AbhinavA10/Rescue-Heroes/Software/Rescue-Bot/src/examples/README.md

This folder houses a collection of misc. examples or older programs to test sensors.

The `main.cpp` file can be replaced with each `.ino` file here, or the `.ino` file can potentially be run using the `Arduino IDE`.
