AbhinavA10/Rescue-Heroes/Electrical/Block-Diagram/Block_Diagram.pdf

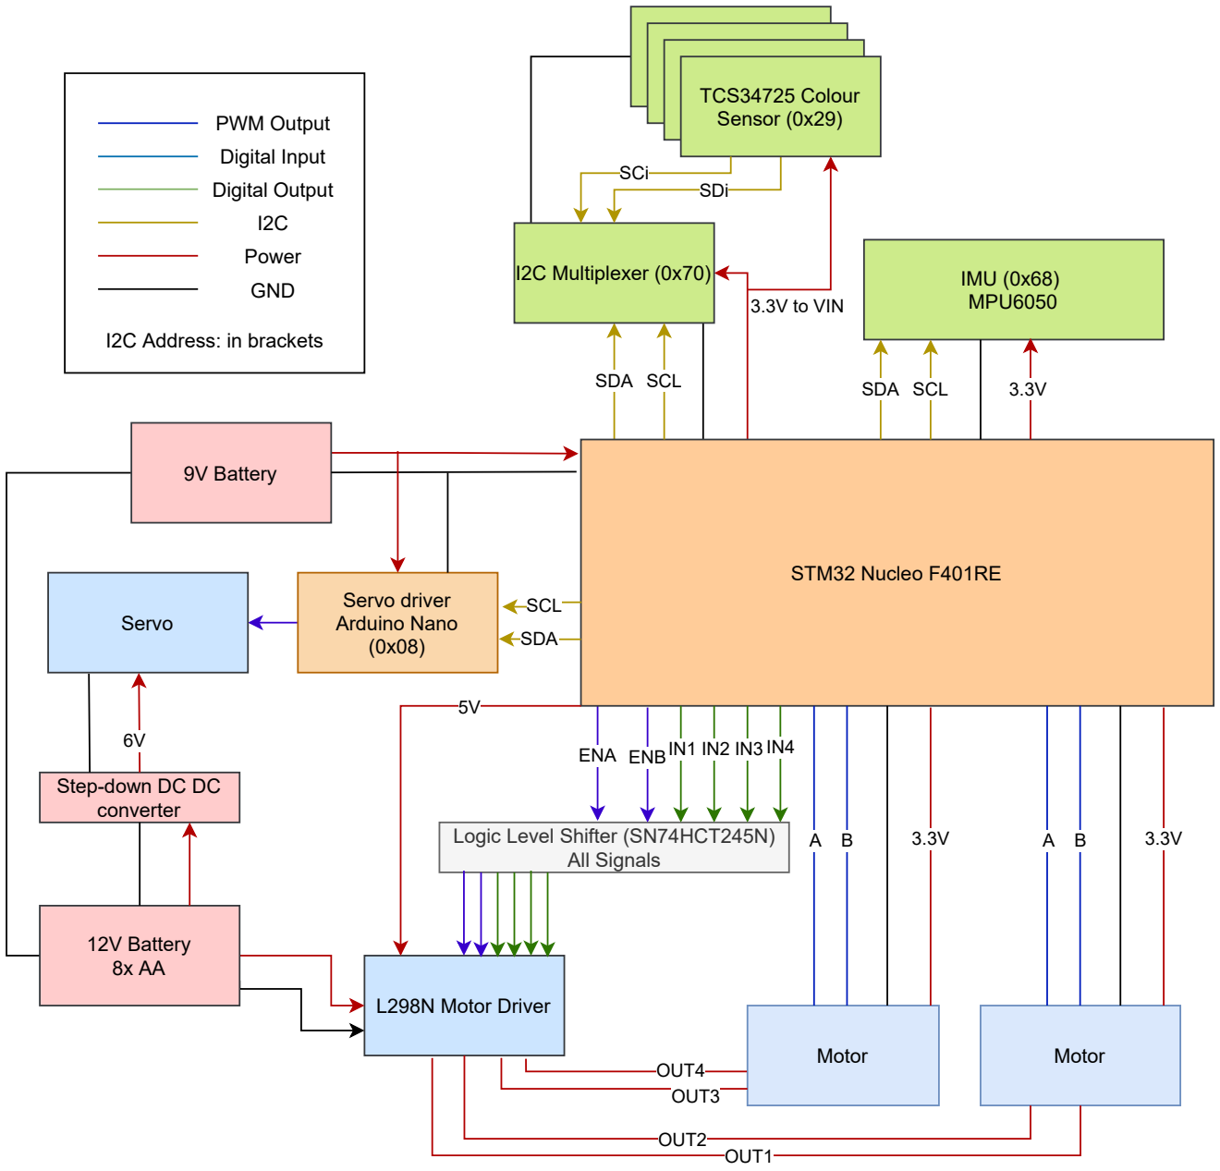
[picture p12: figure]
ENA; 3.3V to VIN; SDA; STM32 Nucleo F401RE; I2C Multiplexer (0x70); TCS34725 Colour Sensor TCS34725 Colour Sensor TCS34725 Colour Sensor; SDi; TCS34725 Colour Sensor (0x29); L298N Motor Driver; Motor; IMU (0x68) MPU6050; Servo; OUT3; OUT4; OUT1; OUT2; 12V Battery 8x AA; 9V Battery; SCi; SCL; SDA SCL; Logic Level Shifter (SN74HCT245N) All Signals; Step-down DC DC converter; ENBIN1 IN2 IN3; Digital Input; Digital Output; Power; GND; PWM Output; I2C Address: in brackets; Servo driver Arduino Nano

OLED Screen (I2C)
(Debugging)
(0x3C)

Buzzer
(Debugging)
