AbhinavA10/Rescue-Heroes/images/delay.png

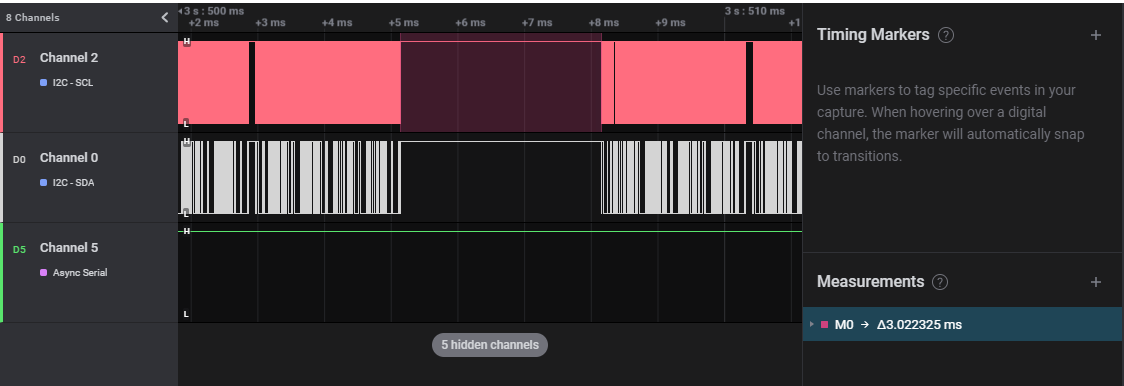
images/delay.png
