AbhinavA10/Rescue-Heroes/images/no_delay.png

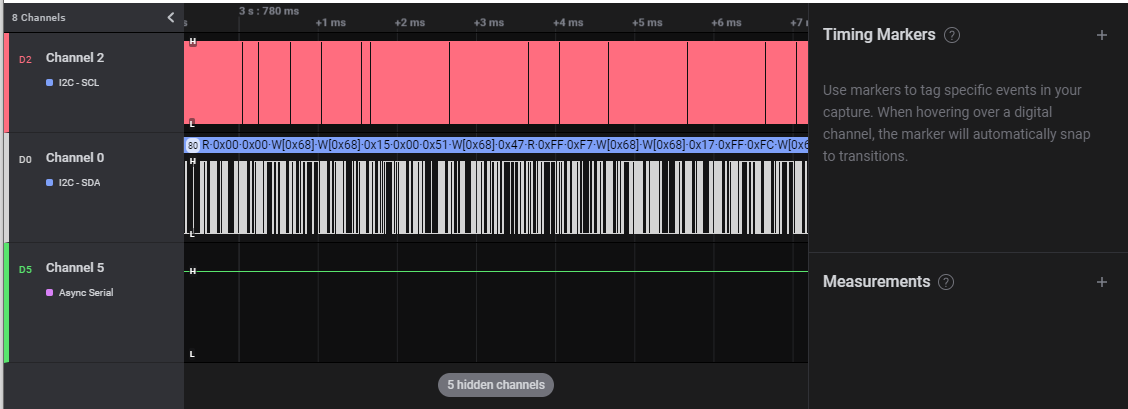
images/no_delay.png
