AbhinavA10/Rescue-Heroes/images/render1_exploded.jpg

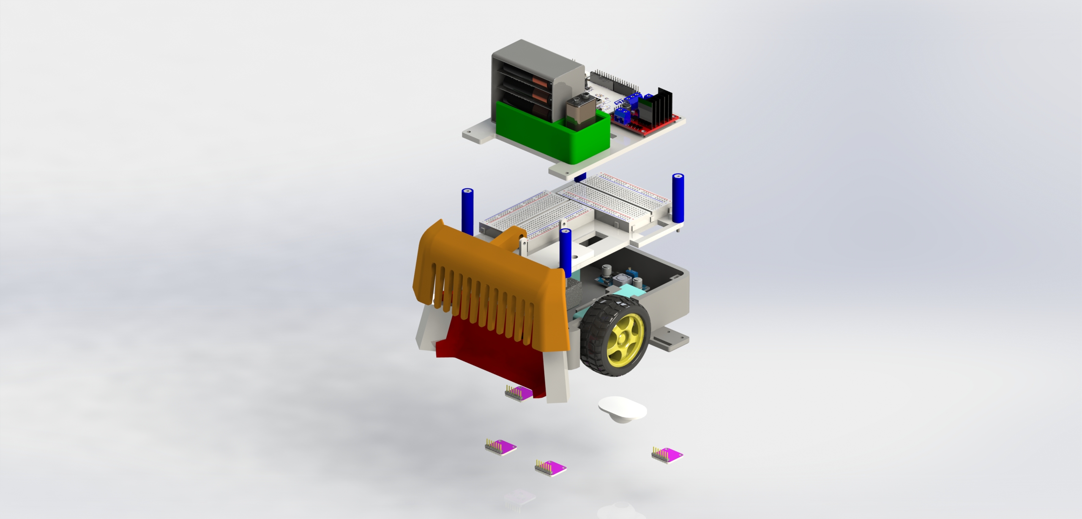
images/render1_exploded.jpg
