AbhinavA10/Rescue-Heroes/Software/Algorithm_Flowcharts/software_algo_dropping.png

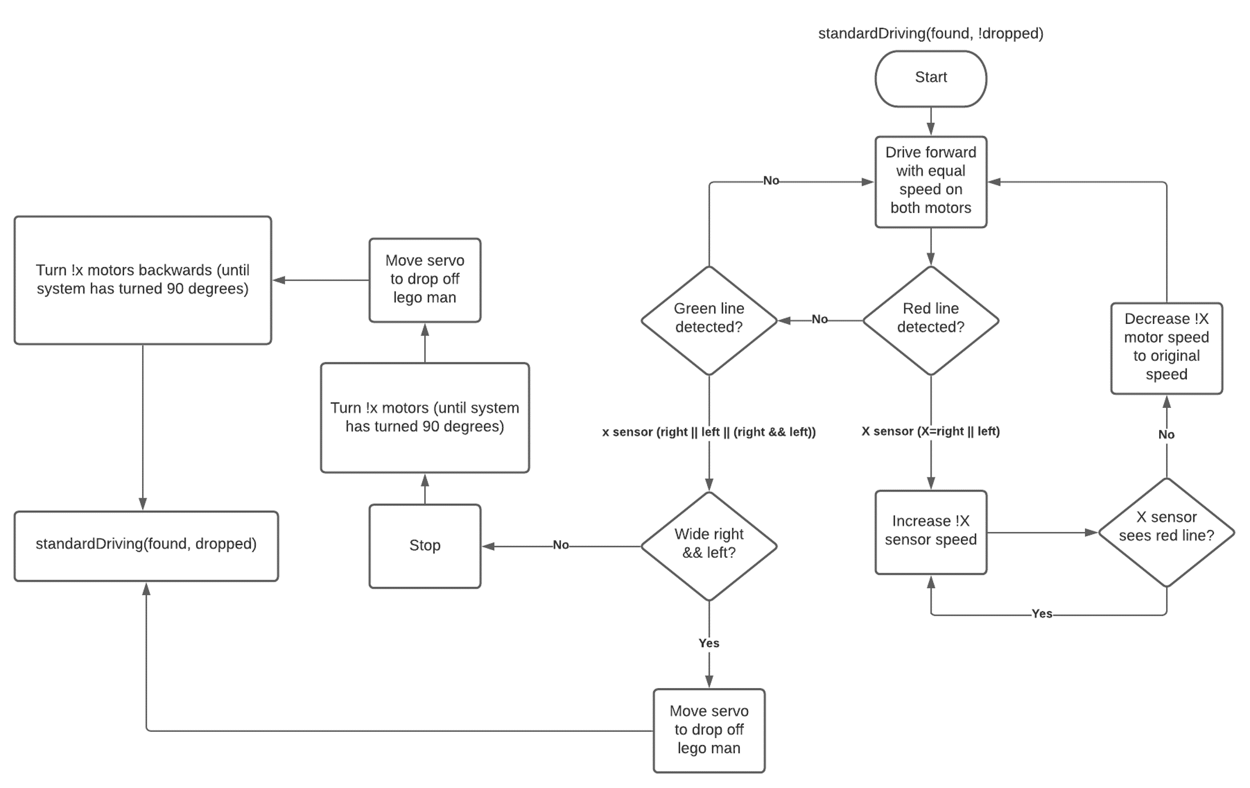
Software/Algorithm_Flowcharts/software_algo_dropping.png
