AbhinavA10/Rescue-Heroes/Software/Algorithm_Flowcharts/software_algo_finding.png

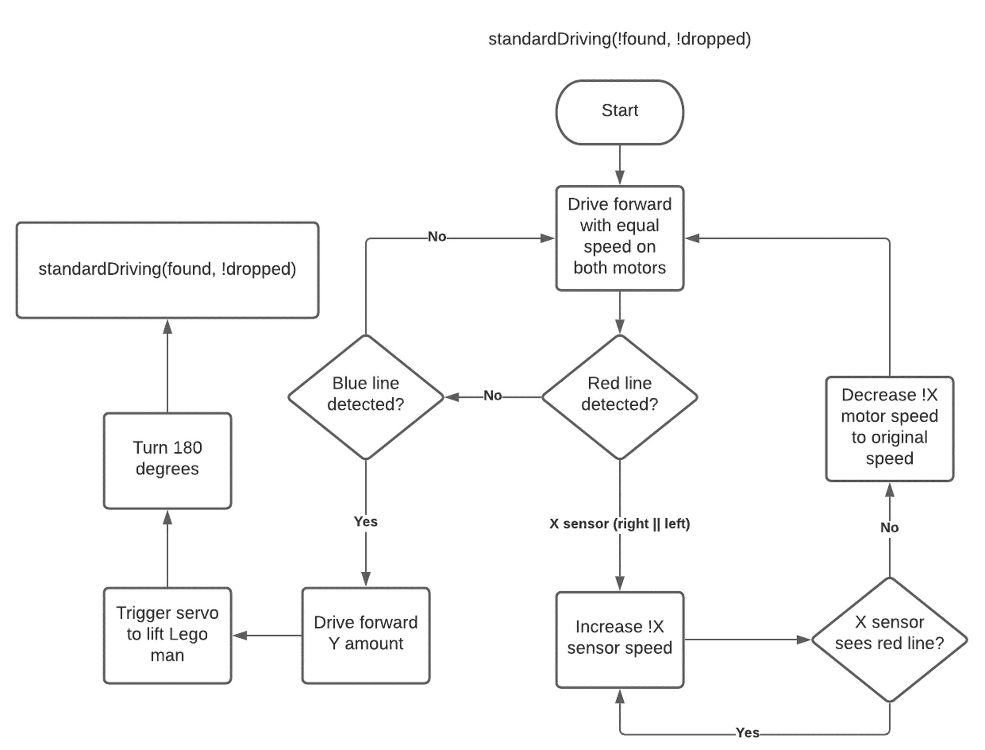
Software/Algorithm_Flowcharts/software_algo_finding.png
