AbhinavA10/Rescue-Heroes/Software/Algorithm_Flowcharts/software_algo_overview.png

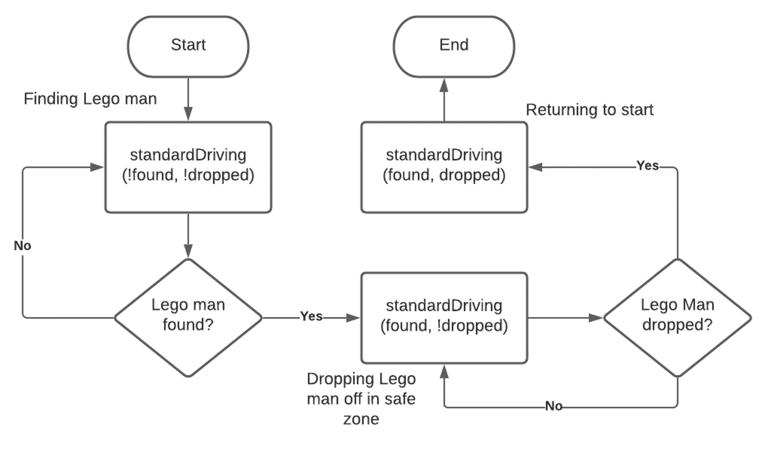
Software/Algorithm_Flowcharts/software_algo_overview.png
