AbhinavA10/Rescue-Heroes/Software/Algorithm_Flowcharts/software_algo_returning.png

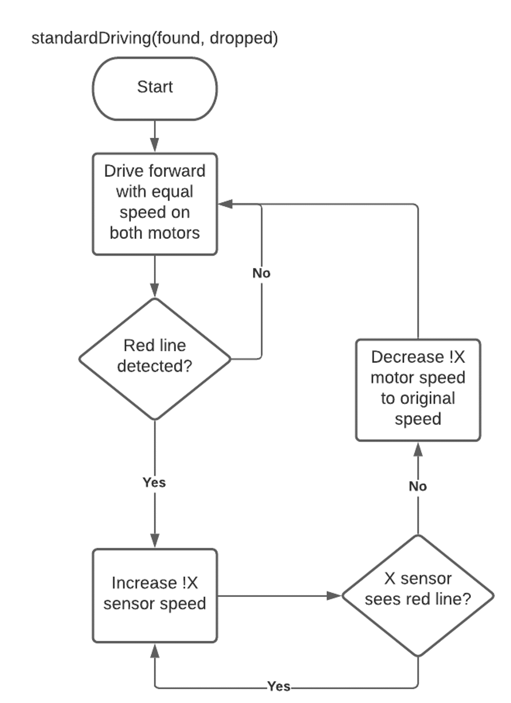
Software/Algorithm_Flowcharts/software_algo_returning.png
