AbhinavA10/Rescue-Heroes/Software/Computer_Colour_Visualization/adafruit_colour_plot.png

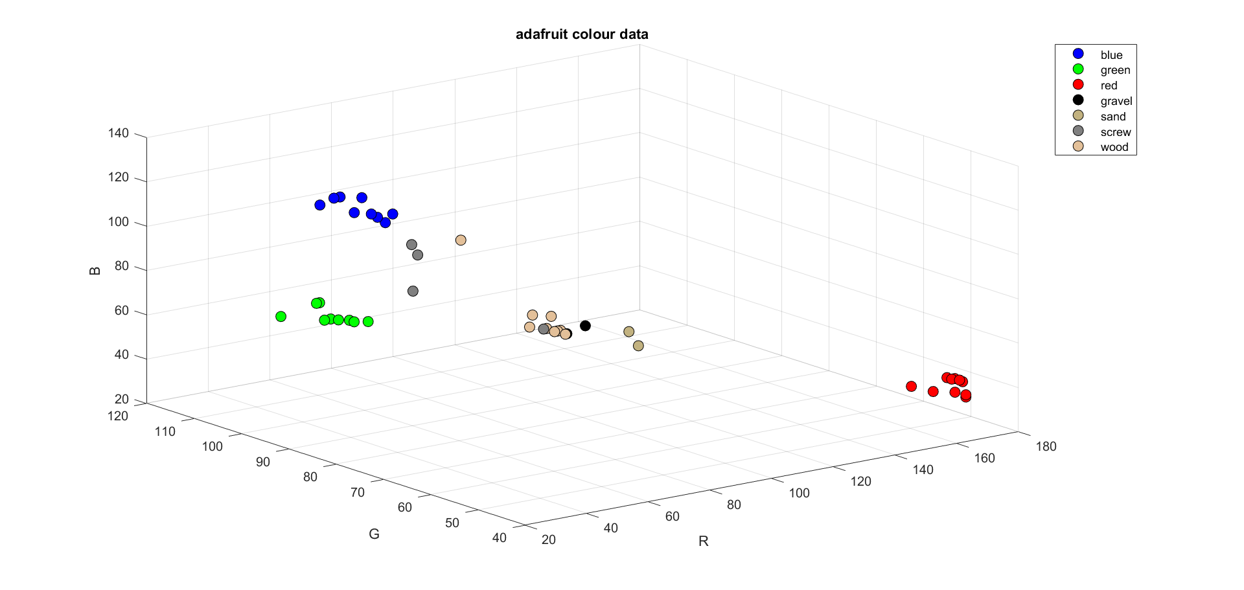
Software/Computer_Colour_Visualization/adafruit_colour_plot.png
