AbhinavA10/Rescue-Heroes/Software/Computer_Colour_Visualization/ebay_colour_plot.png

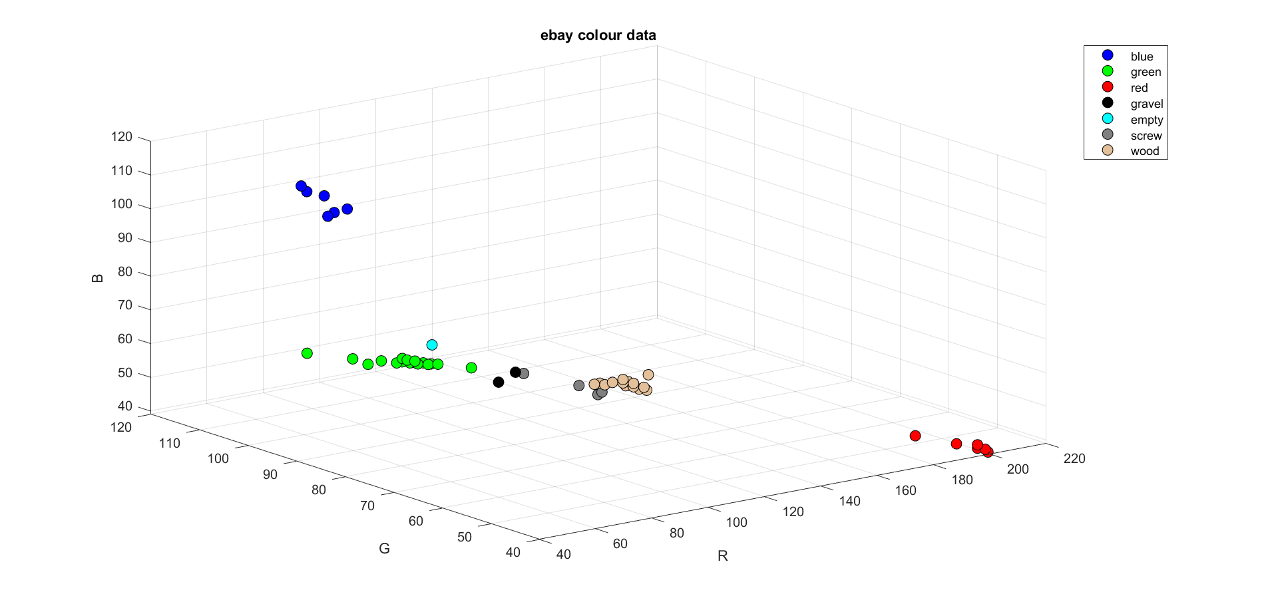
Software/Computer_Colour_Visualization/ebay_colour_plot.png
