AbhinavA10/Rescue-Heroes/Software/Computer_Colour_Visualization/Spheres/spheres_ebay.png

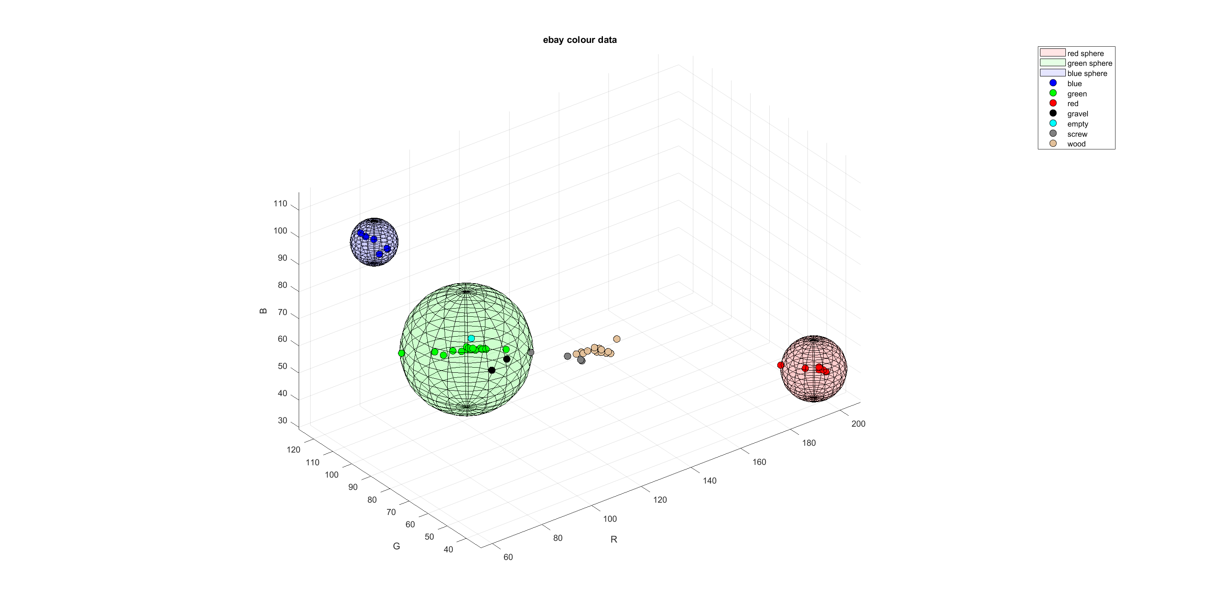
Software/Computer_Colour_Visualization/Spheres/spheres_ebay.png
