AbhinavA10/Rescue-Heroes/Software/Human_Colour_Visualization/ebay_colour_plot_human_visualization.png

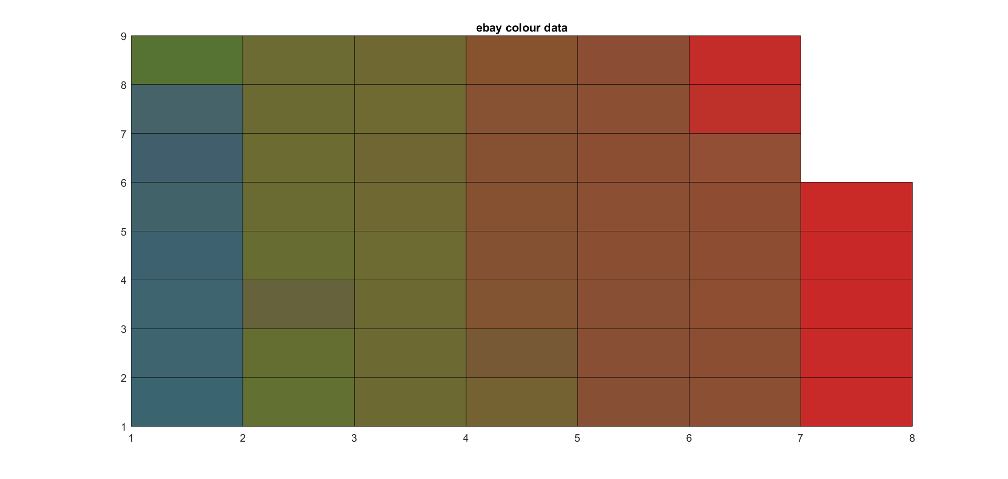
Software/Human_Colour_Visualization/ebay_colour_plot_human_visualization.png
