AbhinavA10/Rescue-Heroes/images/Robot_Assembly_Drawing.pdf

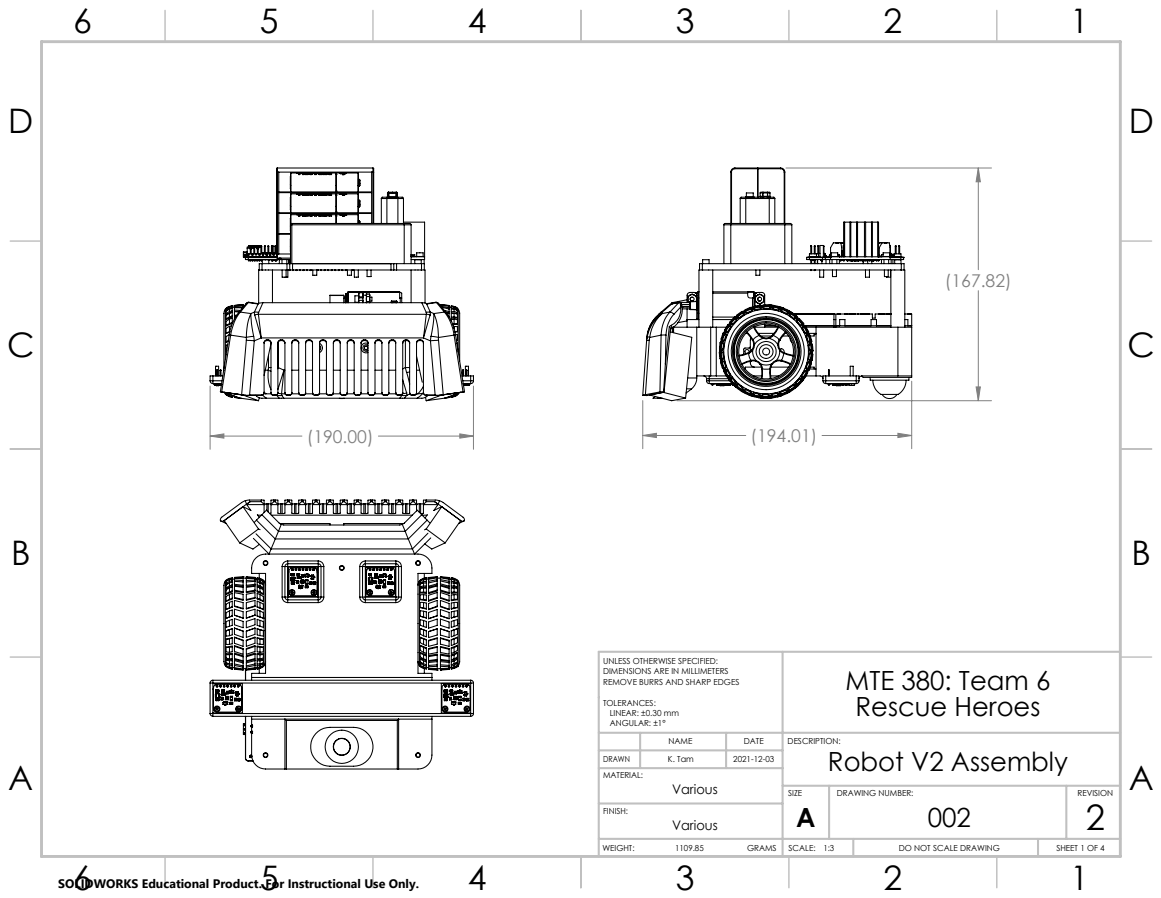
[picture p26: page 1]
DRAWING NUMBER:; SHEET 1 OF 4; GRAMS; DO NOT SCALE DRAWING

UNLESS OTHERWISE SPECIFIED: DIMENSIONS ARE IN MILLIMETERS REMOVE BURRS AND SHARP EDGES TOLERANCES: LINEAR: ±0.30 mm ANGULAR: ±1° | MTE 380: Team 6 Rescue Heroes

NAME | DATE | DESCRIPTION: Robot V2 Assembly SIZE

DRAWN | K. Tam | 2021-12-03

SOLIDWORKS Educational Product. For Instructional Use Only.

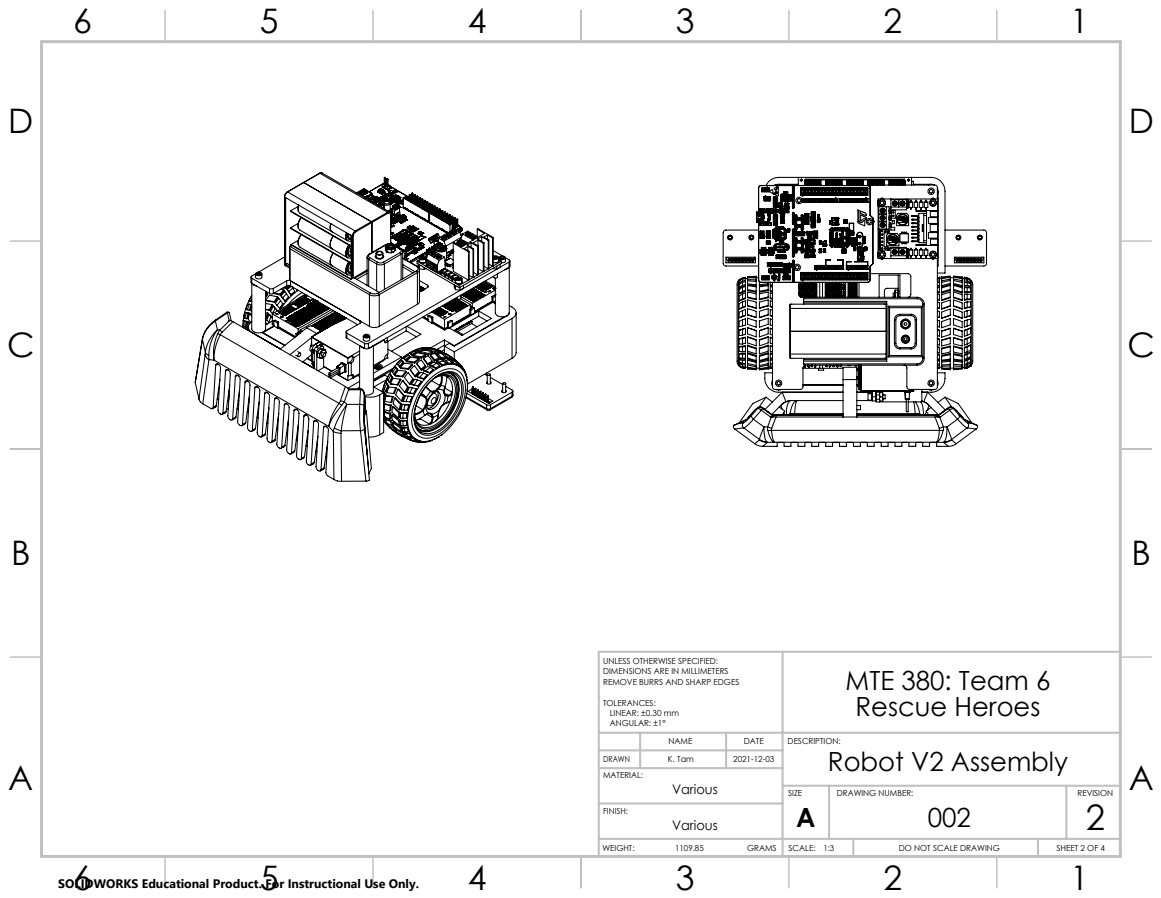
[picture p27: page 2]
DRAWING NUMBER:; GRAMS; DO NOT SCALE DRAWING

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

NAME | DATE | DESCRIPTION: Robot V2 Assembly SIZE

DRAWN | K. Tam | 2021-12-03

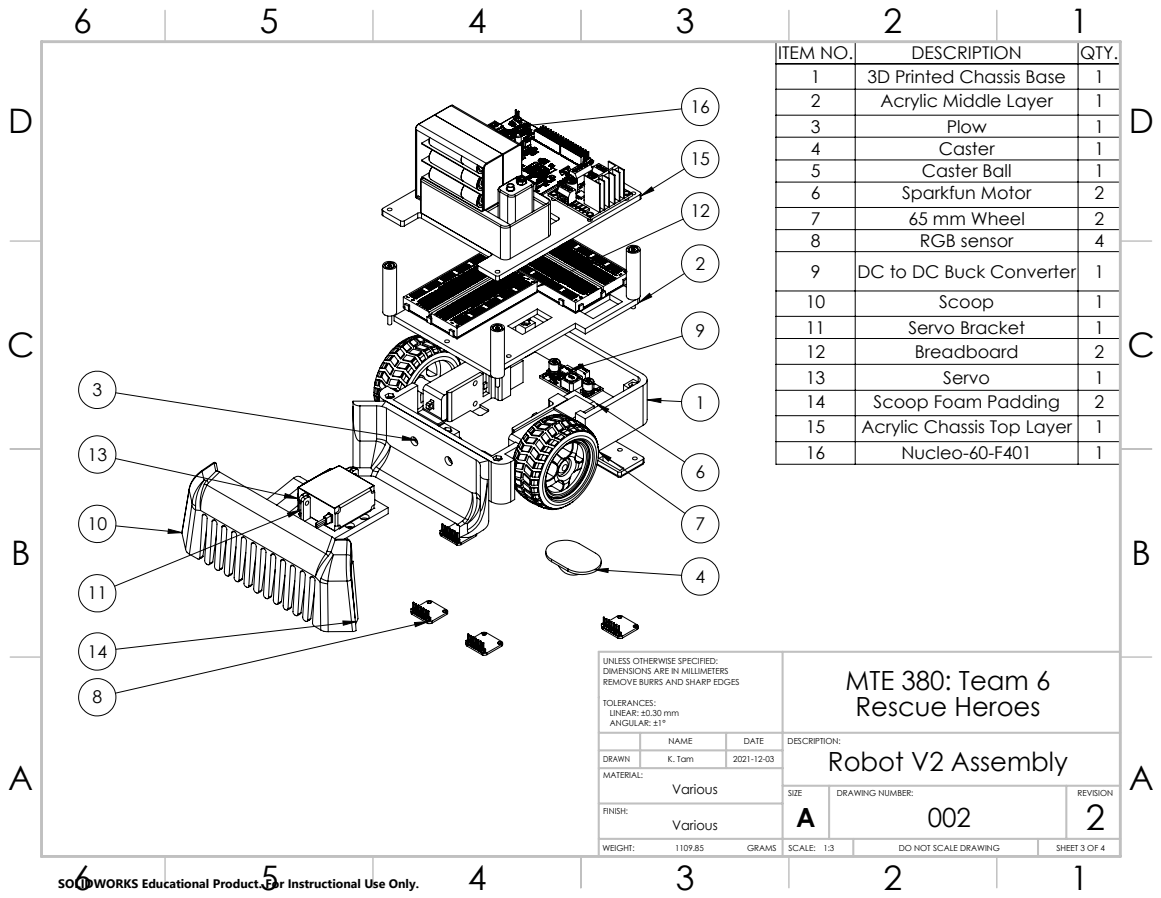
[picture p28: page 3]
DRAWING NUMBER:; GRAMS; DO NOT SCALE DRAWING

ITEM NO. | DESCRIPTION | QTY.
1 | 3D Printed Chassis Base | 1
2 | Acrylic Middle Layer | 1
3 | Plow | 1
4 | Caster | 1
5 | Caster Ball | 1
6 | Sparkfun Motor | 2
7 | 65 mm Wheel | 2
8 | RGB sensor | 4
9 | DC to DC Buck Converter | 1
10 | Scoop | 1
11 | Servo Bracket | 1
12 | Breadboard | 2
13 | Servo | 1
14 | Scoop Foam Padding | 2
15 | Acrylic Chassis Top Layer | 1
16 | Nucleo-60-F401 | 1

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

NAME | DATE | DESCRIPTION: Robot V2 Assembly SIZE

DRAWN | K. Tam | 2021-12-03

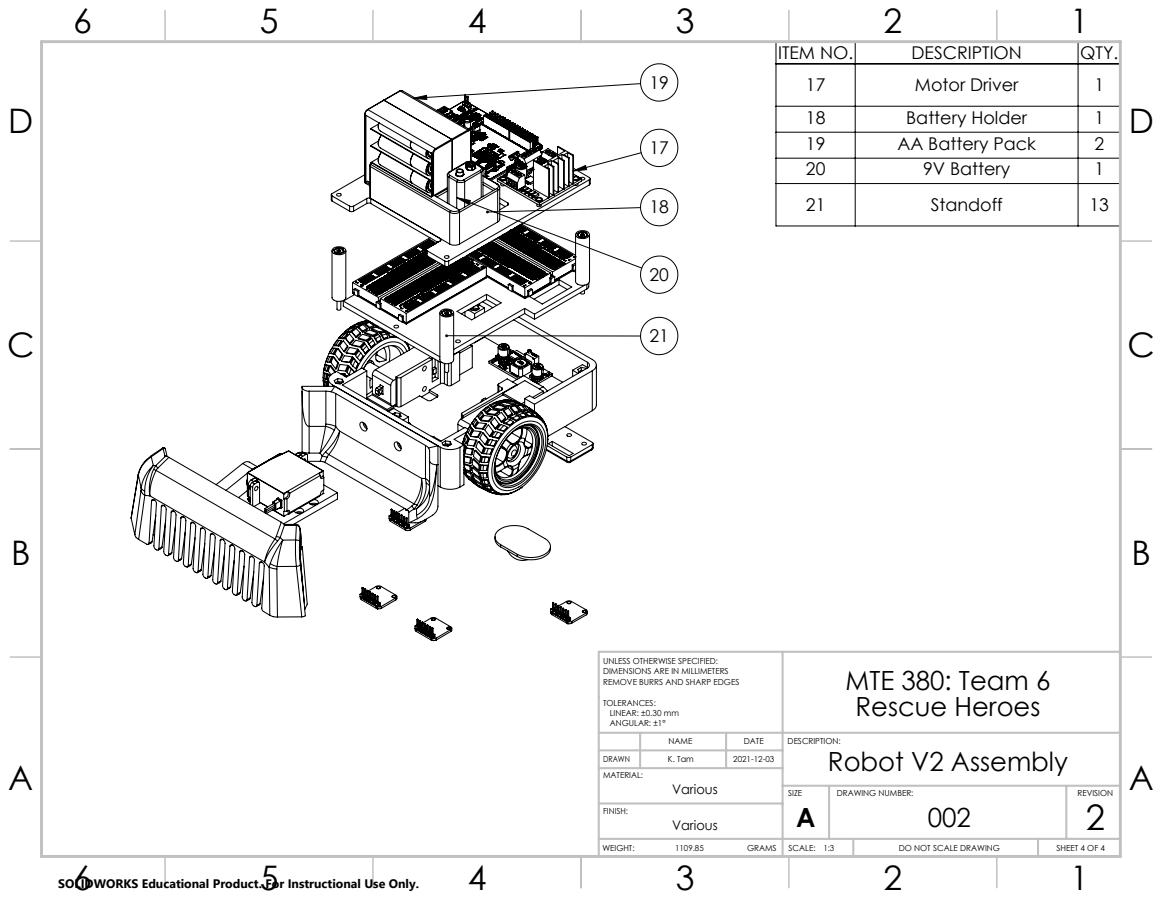
[picture p29: page 4]
DRAWING NUMBER:; GRAMS; DO NOT SCALE DRAWING

ITEM NO. | DESCRIPTION | QTY.
17 | Motor Driver | 1
18 | Battery Holder | 1
19 | AA Battery Pack | 2
20 | 9V Battery | 1
21 | Standoff | 13

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

NAME | DATE | DESCRIPTION: Robot V2 Assembly SIZE

DRAWN | K. Tam | 2021-12-03
