AbhinavA10/Rescue-Heroes/Electrical/Rescue-bot/Rescue-bot-schematic.pdf

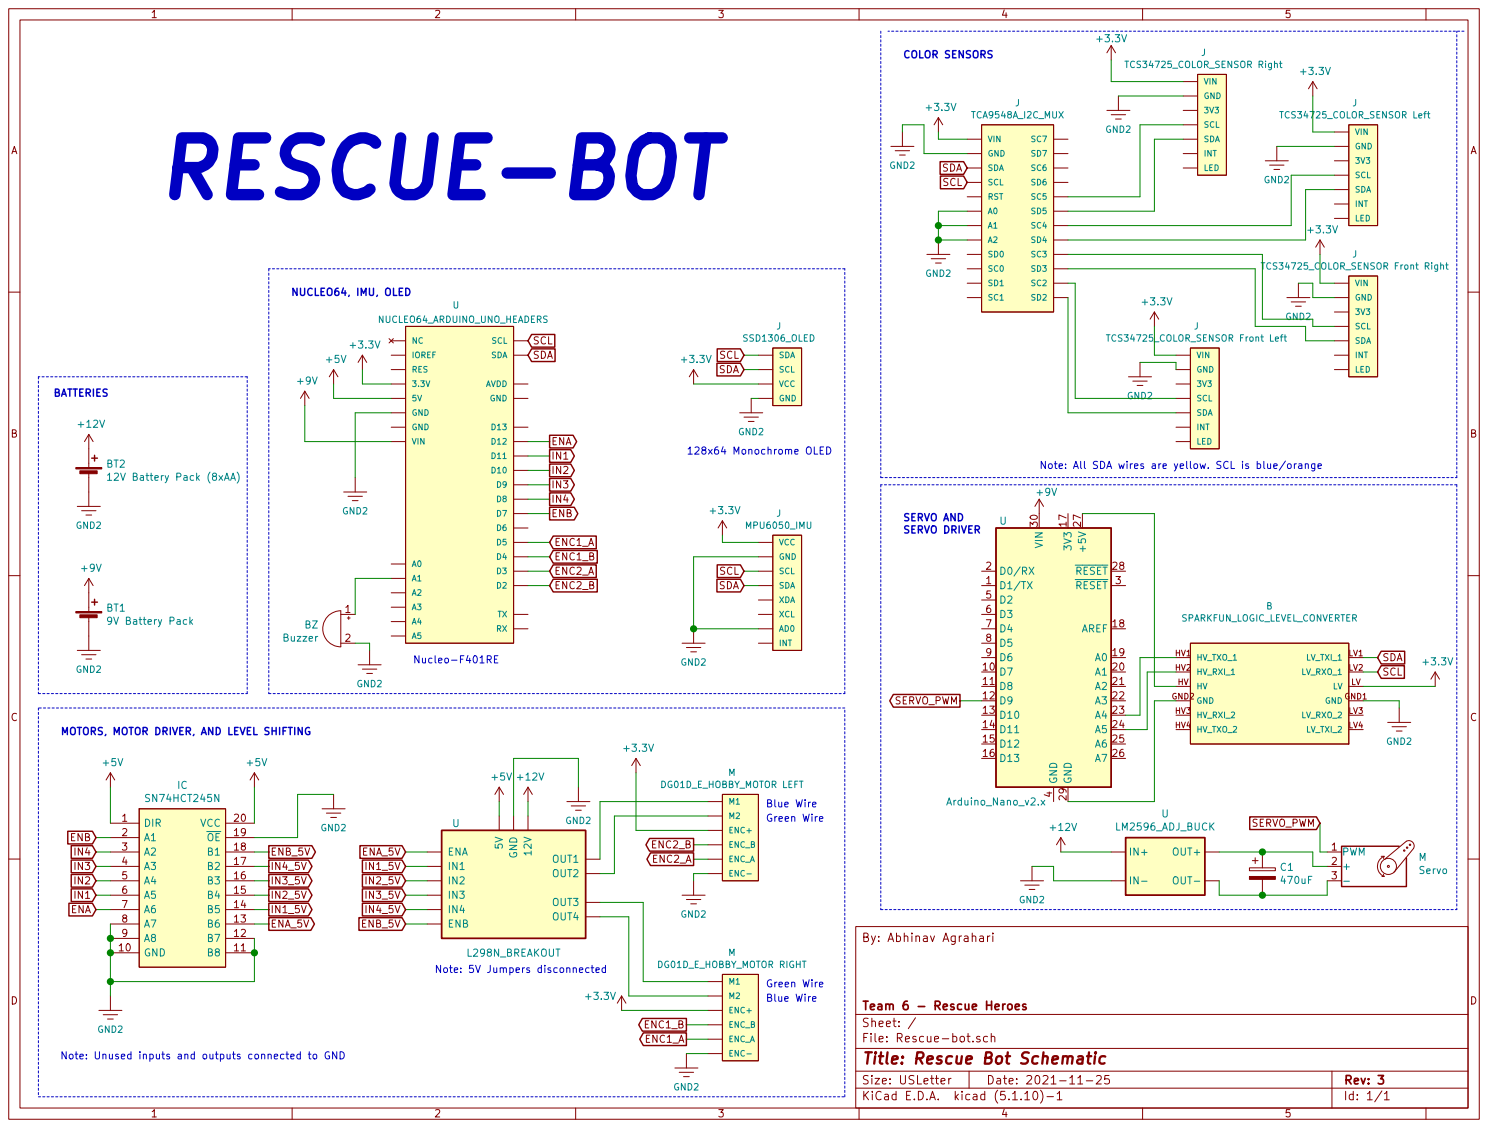
[picture p30: page 1]

Blue Wire RESCUE-BOT

Note: All SDA wires are yellow. SCL is blue/orange

MOTORS, MOTOR DRIVER, AND LEVEL SHIFTING

File: Rescue-bot.sch Sheet: / Team 6 - Rescue Heroes By: Abhinav Agrahari

Note: Unused inputs and outputs connected to GND

Id: 1/1 Title: Rescue Bot Schematic
