AbhinavA10/Rescue-Heroes/Software/Rescue-Bot/src/sensors/colorsensor.h

//Class wrapper for the Adafruit TCS34725 color sensor

#ifndef _COLORSENSOR_H_
#define _COLORSENSOR_H_

#include <Arduino.h>
#include "config.h"
#include "Adafruit_TCS34725.h"

// Define the collected constants for the color sensor
#define COLOR_RED_R_ADAFRUIT 164.6
#define COLOR_RED_G_ADAFRUIT 44.3
#define COLOR_RED_B_ADAFRUIT 41.8
#define COLOR_RED_MAX_DISTANCE_ADAFRUIT 25

#define COLOR_GREEN_R_ADAFRUIT 69.22
#define COLOR_GREEN_G_ADAFRUIT 107.36
#define COLOR_GREEN_B_ADAFRUIT 50.75
#define COLOR_GREEN_MAX_DISTANCE_ADAFRUIT 19

#define COLOR_BLUE_R_ADAFRUIT 29.11
#define COLOR_BLUE_G_ADAFRUIT 80.89
#define COLOR_BLUE_B_ADAFRUIT 132.33
#define COLOR_BLUE_MAX_DISTANCE_ADAFRUIT 25

#define COLOR_RED_R_EBAY 197.57
#define COLOR_RED_G_EBAY 42.86
#define COLOR_RED_B_EBAY 40.43
#define COLOR_RED_MAX_DISTANCE_EBAY 30

#define COLOR_GREEN_R_EBAY 106.41
#define COLOR_GREEN_G_EBAY 106.35
#define COLOR_GREEN_B_EBAY 50.35
#define COLOR_GREEN_MAX_DISTANCE_EBAY 19

#define COLOR_BLUE_R_EBAY 63.14
#define COLOR_BLUE_G_EBAY 98.29
#define COLOR_BLUE_B_EBAY 109
#define COLOR_BLUE_MAX_DISTANCE_EBAY 15

enum class ColorSensorType : uint8_t
{
    EBAY,
    ADAFRUIT,
};

enum class ColorClass : uint8_t
{
    NO_COLOR,
    RED,
    GREEN,
    BLUE
};

class ColorSensor
{
public:
    ColorSensor(ColorSensorType type);
    bool init();

    void readColor();
    void classifyColor();
    ColorClass getCurrentColor();

private:
    // Adafruit library object
    const ColorSensorType type_; // Ebay or Adafruit
    Adafruit_TCS34725 sensor_;   // sensor object for Adafruit library
    float red_;                  // temp variable
    float green_;                // temp variable
    float blue_;                 // temp variable
    ColorClass currentColor_;    // most recently sensed color

    // Color Average constants for specific type of sensor
    float RED_AVG[3] = {0}; // index is R,G,B
    float GREEN_AVG[3] = {0};
    float BLUE_AVG[3] = {0};
    float RED_MAX_DIST = 0;
    float GREEN_MAX_DIST = 0;
    float BLUE_MAX_DIST = 0;
};

#endif
