AbhinavA10/Rescue-Heroes/Software/Rescue-Bot/src/task/display.cpp

#include "display.h"

namespace Display
{
    Adafruit_SSD1306 display = Adafruit_SSD1306(SCREEN_WIDTH, SCREEN_HEIGHT, &Wire, OLED_RESET);
    String text[8] = {""};

    void testdrawchar(void)
    {
        display.clearDisplay();
        display.setTextSize(1);              // Normal 1:1 pixel scale
        display.setTextColor(SSD1306_WHITE); // Draw white text
        display.setCursor(0, 0);             // Start at top-left corner
        display.cp437(true);                 // Use full 256 char 'Code Page 437' font
        // Not all the characters will fit on the display. This is normal.
        // Library will draw what it can and the rest will be clipped.
        for (int16_t i = 0; i < 256; i++)
        {
            if (i == '\n')
                display.write(' ');
            else
                display.write(i);
        }
        display.display();
        delay(1000);
    }

    void testdrawstyles(void)
    {
        display.clearDisplay();
        display.setTextSize(1);              // Normal 1:1 pixel scale
        display.setTextColor(SSD1306_WHITE); // Draw white text
        display.setCursor(0, 0);             // Start at top-left corner
        display.println(F("Hello, world!"));
        display.setTextColor(SSD1306_BLACK, SSD1306_WHITE); // Draw 'inverse' text
        display.println(3.141592);
        display.setTextSize(2); // Draw 2X-scale text
        display.setTextColor(SSD1306_WHITE);
        display.print(F("0x"));
        display.println(0xDEADBEEF, HEX);
        display.display();
        delay(1000);
    }
    void init_display()
    {
        // SSD1306_SWITCHCAPVCC = generate display voltage from 3.3V internally
        if (!display.begin(SSD1306_SWITCHCAPVCC, OLED_SCREEN_ADDRESS))
        {
            Serial.println(F("SSD1306 allocation failed"));
            for (;;)
                ; // Don't proceed, loop forever
        }
        // Show initial display buffer contents on the screen --
        // the library initializes this with an Adafruit splash screen.
        display.display();
        delay(100); // show splashscreen for a bit, to show I2C interface works
    }

    // Redraw display with data from array
    void refresh_display()
    {
        display.clearDisplay();
        display.setTextSize(1);
        display.setTextColor(SSD1306_WHITE); // Draw white text
        display.setCursor(0, 0);             // Start at top-left corner
        for (int i = 0; i < 8; i++)
        {
            display.println(text[i]);
        }
        display.display();
    }
    void refresh_display_big(int val)
    {
        display.clearDisplay();
        display.setTextSize(4);
        display.setTextColor(SSD1306_WHITE); // Draw white text
        display.setCursor(0, 0);             // Start at top-left corner
        display.println(val);
        display.display();
    }
    void test_display()
    {
        testdrawchar();   // Draw characters of the default font
        testdrawstyles(); // Draw 'stylized' characters
    }
};
