AbhinavA10/Rescue-Heroes/(commit log)

2021-10-27 Add NUCELO Schematics and datasheet
2021-10-29 Add collected colour sensor data
    [data_adafruit_1.csv, data_adafruit_2.csv, data_adafruit_2_screw.csv, data_adafruit_2_test2.csv, data_adafruit_gravel.csv, data_ebay_1.csv, data_ebay_1_screw.csv, data_ebay_2.csv]
2021-10-31 Markup 74HCT245 Datasheet
    [schematic.kicad_pcb, schematic.sch]
2021-11-01 Test 74HCT245 with PWM signals
    [Level-shifter-test.kicad_pcb, Level-shifter-test.sch, data_adafruit_1.csv, data_adafruit_2.csv, data_adafruit_2_screw.csv, data_adafruit_2_test2.csv, data_adafruit_gravel.csv, data_ebay_1.csv]
2021-11-04 adafruit and ebay data combined
    [data_adafruit_all.csv, data_ebay_all.csv]
2021-11-06 Rearrange 74HCT schematic
    [Level-shifter-test.sch]
2021-11-06 data average and euclidean distances calculated
    [data_averages_all.xlsx]
2021-11-11 Add IMU library
    Solves compilation issues
    [config.h, imu.cpp, imu.h, main.cpp, read_sensors.cpp]
2021-11-11 Add startup buzzer
    [Pin_Assignment.xlsx]
2021-11-11 Test motor driver
2021-11-11 Add basic color sensor and I2C Mux
2021-11-13 Start encoders and test drive till red
2021-11-13 Milestone4 imu code
2021-11-13 Test color sensors and IMU
    All tests for Milestone4 are successful. Robot is able to stop at red
    tape line, and roughly return to original orientation.
2021-11-13 Test servo positions
2021-11-13 Update OLED with Sensor init statuses
2021-11-15 Refactor color sensor class
2021-11-15 Cleanup IMU class and interface
2021-11-15 Add examples of reading sensors in nav thread
    Also make currentColor a private member of ColorSensor class
2021-11-16 typo fix on do_follow_red_line
    [navigation.cpp]
2021-11-16 typo fix for do_follow_red_line
    [navigation.cpp]
2021-11-16 Added do_dropoff_lego_man (Missing a couple parts)
    [navigation.cpp]
2021-11-16 Add do_pick_up_lego_man (Missing some parts)
    [navigation.cpp]
2021-11-17 Add Color sensor library to lib folder
2021-11-17 Remove delay from Adafruit ColorSensor library
    Eliminates unnecassary delay between multiple color sensors
2021-11-17 Changed Variables to Static and added servo actions
2021-11-17 Remove references to TaskScheduler
    - TaskScheduler is no longer being used
    - Structure class calls and stop at red tape
    - Stop at Red tape through Naivgation class
    [config.h, display.cpp, display.h, main.cpp, motor_control.cpp, motor_control.h, motors.cpp, navigation.cpp]
2021-11-17 Test rear color sensors with green
2021-11-18 Cleanup motor classes
2021-11-18 Fix reading of encoders
    [motor_control.cpp, motor_control.h, motors.cpp, motors.h, navigation.cpp, navigation.h, pin_assignment.h]
2021-11-18 Add timed spin functions
    Adding in case these are needed for adjusting turning
2021-11-18 Move motors fixed distance
    [config.h, main.cpp, motor_control.cpp, motor_control.h, navigation.cpp, navigation.h]
2021-11-18 Move sensor reading to seperate namespace
2021-11-18 Add tests for Servo and IMU
2021-11-18 Remove delay from main loop()
    Reading from 3 color sensors takes 6ms.
    This is > than color sensor integration time.
    Also test basic line following with this change
    and while reading IMU
2021-11-18 Use updated motor interface
2021-11-18 IMU cleanup
2021-11-19 Use normalized yaw for 180 deg turn
2021-11-19 Record wiring on Pins
2021-11-22 Adjustments for new wiring
2021-11-22 Use angles for servo
2021-11-22 Add example I2C communication between nano
2021-11-22 Integrate Arduino dedicated servo driver
2021-11-22 Add PID Speed control, tune params, and test
2021-11-22 Use PID motor commands during navigation
2021-11-22 Follow red line with PID
    - Find correct speed to follow red line when
    finding lego man
    - Disable PID when turning during following red line
    - Read from IMU only if needed
    [motor_control.cpp, motor_control.h, navigation.cpp, read_sensors.cpp]
2021-11-22 Fix turning back onto red line after dropoff
    [navigation.cpp]
2021-11-22 fix stop at end
    [navigation.cpp]
2021-11-22 Change open servo angle
    Was getting caught in the wall
2021-11-27 Start update of Complete Schematic
    [Pin_Assignment.xlsx, Rescue-bot.kicad_pcb, Rescue-bot.sch]
2021-11-28 Schematic - Complete ColorSensors and Servo
    [Rescue-bot.sch]
2021-11-29 Finish Schematic
    [Rescue-bot.sch]
2022-01-08 Add matlab scripts for Color Sensor thresholding
2022-01-08 Add schematic and animation to readme
